PeterSewell/nonrotating_necklace/necklace/README.md

# files

 necklace.ino        // the main Arduino sketch 
 poor_mans_printf.h  // poor-man's printf library
 vectors.h           // simple vector library
 memory_usage.h      // misc code from the web to display memory usage
 neopixels.h         // neopixel config and initialisation
 dynamics_config.h   // dynamics config values 
 dynamics_state.h    // dynamics state variables 
 radio_type.h        // type for radio packet
 radio_marshalling.h // marshal and unmarshal radio data
 radio.h             // sending/receiving state over radio 
 print_state.h       // printing state to serial
 colours.h           // colour random walk
 mpu.h               // reading data from MPU
 dynamics.h          // calculation of rotation rate and north angle
 display.h           // display on LEDs
