PeterSewell/nonrotating_necklace/media/DSD_5231.JPG

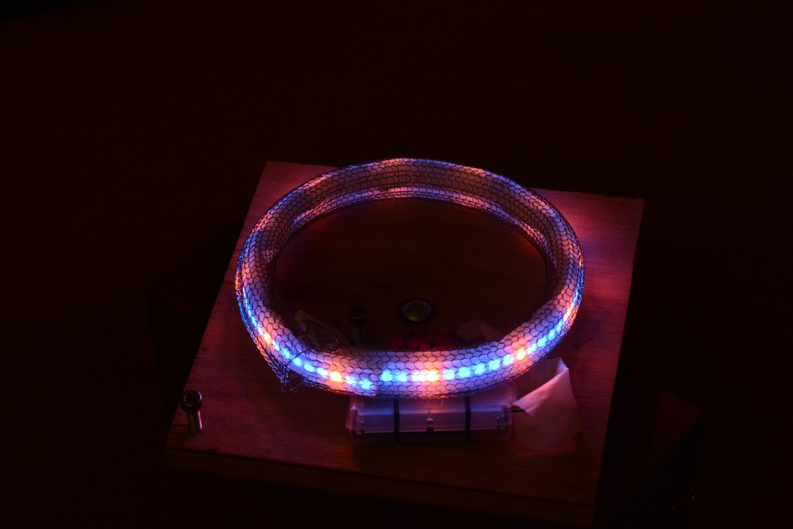
media/DSD_5231.JPG
