PeterSewell/nonrotating_necklace/media/DSD_5247.JPG

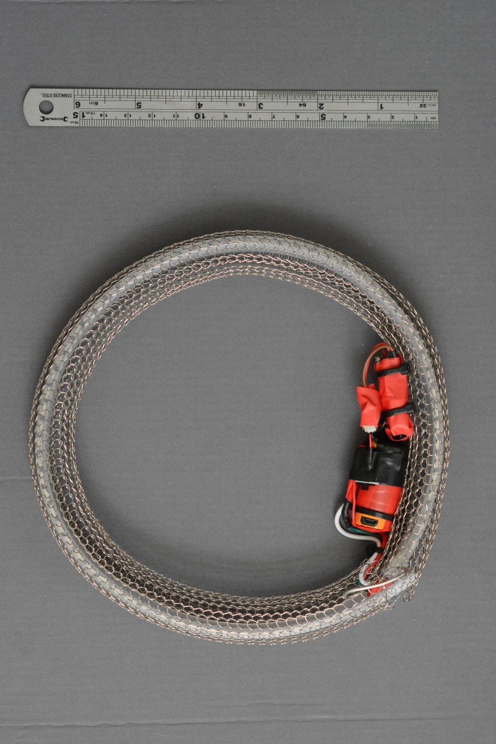
media/DSD_5247.JPG
