PeterSewell/nonrotating_necklace/media/DSD_5290.JPG

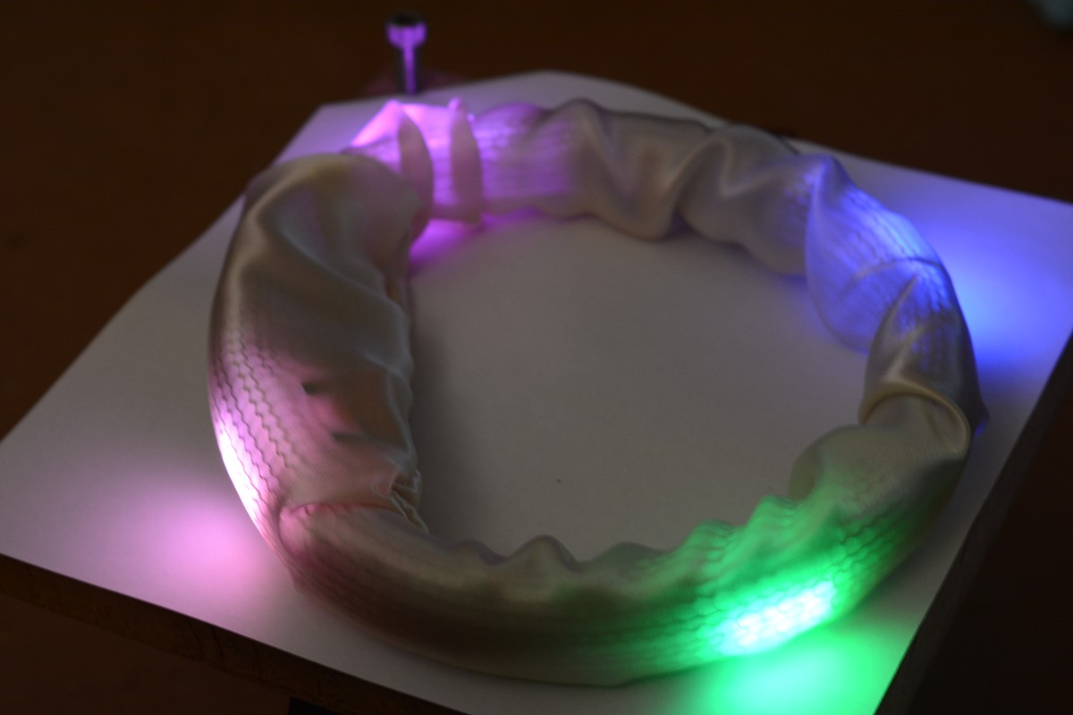
media/DSD_5290.JPG
