PeterSewell/nonrotating_necklace/necklace/memory_usage.h

// various code from the web trying to measure max memory usage


// ********************* 

/* This function places the current value of the heap and stack pointers in the
 * variables. You can call it from any place in your code and save the data for
 * outputting or displaying later. This allows you to check at different parts of
 * your program flow.
 * The stack pointer starts at the top of RAM and grows downwards. The heap pointer
 * starts just above the static variables etc. and grows upwards. SP should always
 * be larger than HP or you'll be in big trouble! The smaller the gap, the more
 * careful you need to be. Julian Gall 6-Feb-2009.
 */




// this function will return the number of bytes currently free in RAM
// written by David A. Mellis
// based on code by Rob Faludi http://www.faludi.com
int availableMemory() {
  int size = 1024; // Use 2048 with ATmega328
  byte *buf;
  while ((buf = (byte *) malloc(--size)) == NULL)
    ;
  free(buf);
  return size;
}


#ifdef __arm__
// should use uinstd.h to define sbrk but Due causes a conflict
extern "C" char* sbrk(int incr);
#else  // __ARM__
extern char *__brkval;
#endif  // __arm__
 
int freeMemory() {
  char top;
#ifdef __arm__
  return &top - reinterpret_cast<char*>(sbrk(0));
#elif defined(CORE_TEENSY) || (ARDUINO > 103 && ARDUINO != 151)
  return &top - __brkval;
#else  // __arm__
  return __brkval ? &top - __brkval : &top - __malloc_heap_start;
#endif  // __arm__
}



uint8_t * heapptr, * stackptr;
void check_mem(char *s) {
  Serial.print("check_mem at ");Serial.print(s);Serial.println("");
  stackptr = (uint8_t *)malloc(4);          // use stackptr temporarily
  heapptr = stackptr;                     // save value of heap pointer
  free(stackptr);      // free up the memory again (sets stackptr to 0)
  stackptr =  (uint8_t *)(SP);           // save value of stack pointer
  Serial.print("heapptr="); Serial.print((uintptr_t)heapptr);
  Serial.print("stackptr="); Serial.print((uintptr_t)stackptr);
  Serial.println("");

  Serial.print("stack-heap estimate=");Serial.print(freeMemory());

  //  Serial.print("malloc-try estimate=");Serial.print(availableMemory());

}
